xujianningkp/Wireless-Data-Traansmission/raspberry pi files/www/images/relaytower.PNG

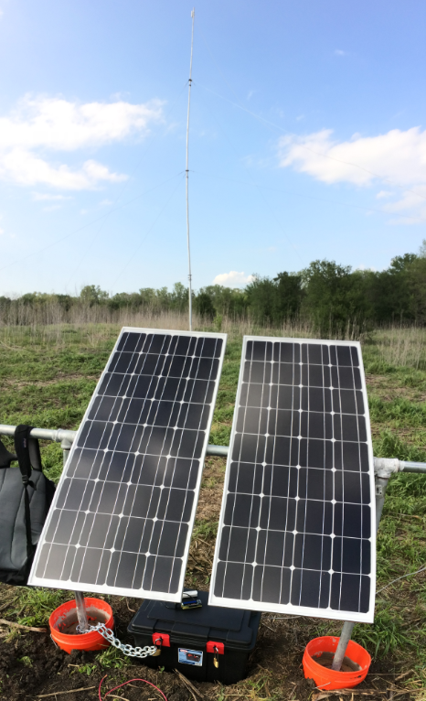
raspberry pi files/www/images/relaytower.PNG
