xujianningkp/Wireless-Data-Traansmission/raspberry pi files/www/images/nhctower.PNG

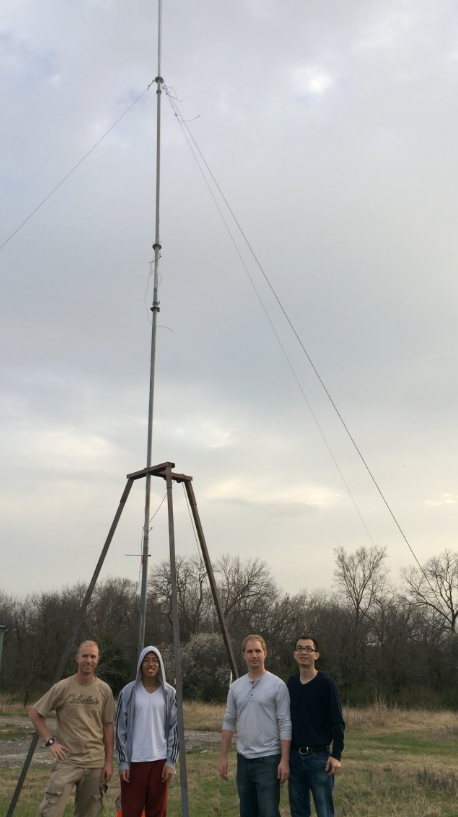
raspberry pi files/www/images/nhctower.PNG
