xujianningkp/Wireless-Data-Traansmission/moteino codes/readme.txt

libraries you will need to copy to your arduino IDE library directory.

low_Power:    power saving mode
RFM69:        RFM69W radio
RTClib:       Real time clock

Moteino order:

send -> receive -> end
