xujianningkp/Wireless-Data-Traansmission/raspberry pi files/www/images/background.png

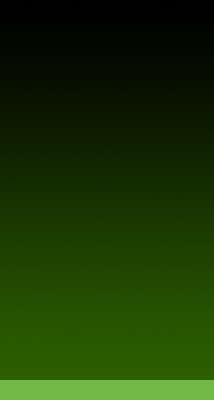
raspberry pi files/www/images/background.png
