xujianningkp/Wireless-Data-Traansmission/raspberry pi files/www/images/digram.PNG

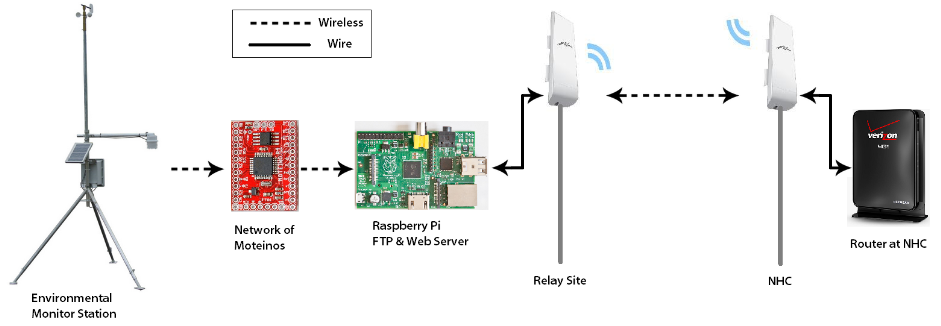
raspberry pi files/www/images/digram.PNG
