xujianningkp/Wireless-Data-Traansmission/raspberry pi files/www/images/moteino.PNG

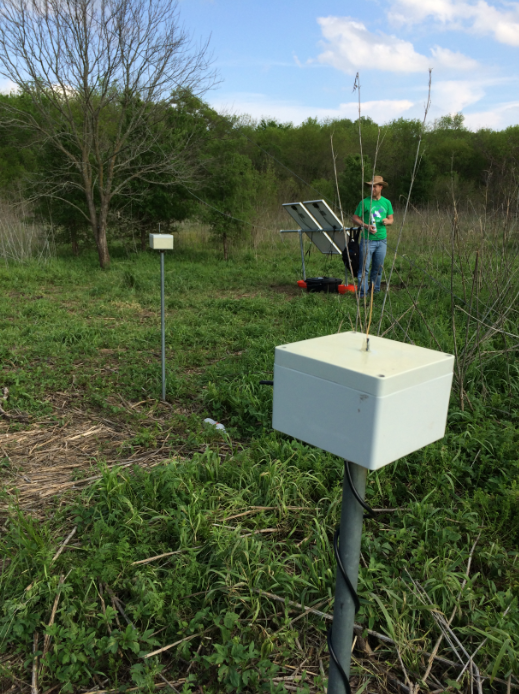
raspberry pi files/www/images/moteino.PNG
