xujianningkp/Wireless-Data-Traansmission/raspberry pi files/www/images/nhcmap.PNG

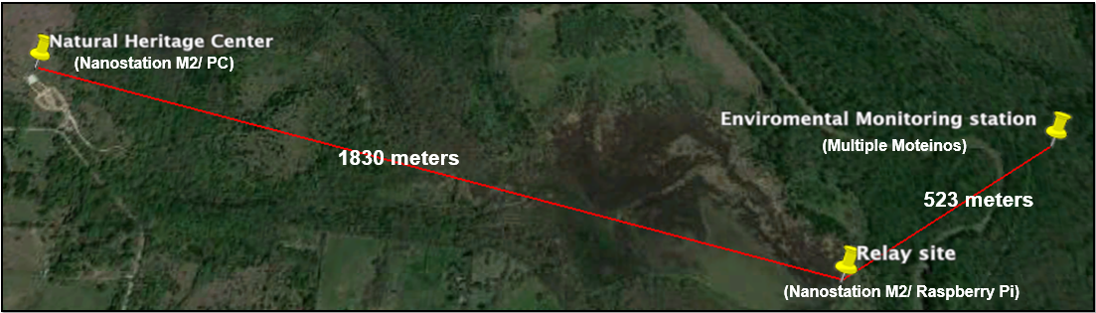
raspberry pi files/www/images/nhcmap.PNG
