xujianningkp/Wireless-Data-Traansmission/raspberry pi files/www/images/NHCproject.JPG

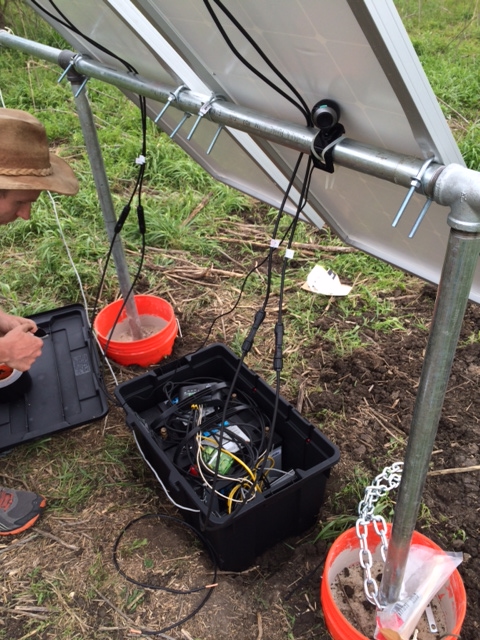
raspberry pi files/www/images/NHCproject.JPG
