xujianningkp/Wireless-Data-Traansmission/raspberry pi files/www/images/project2.JPG

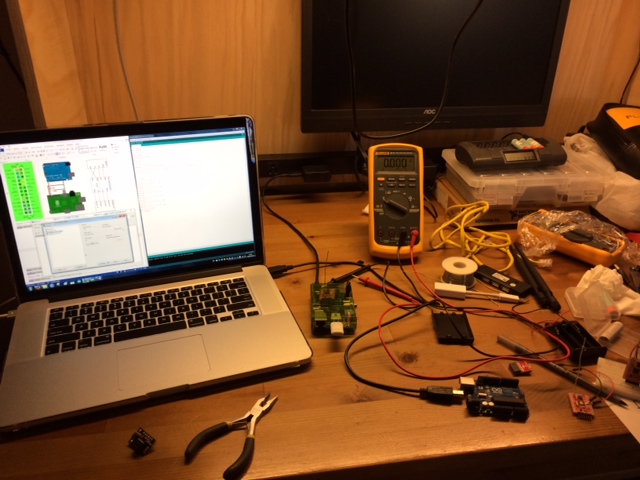
raspberry pi files/www/images/project2.JPG
