xujianningkp/Wireless-Data-Traansmission/raspberry pi files/www/images/rpidatalogger.PNG

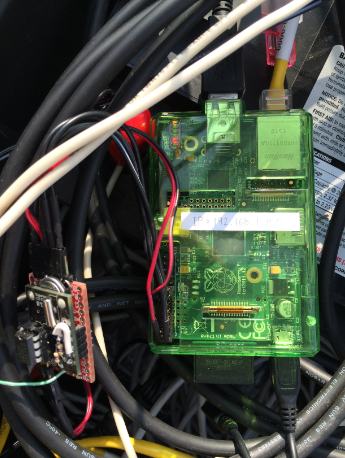
raspberry pi files/www/images/rpidatalogger.PNG
