xujianningkp/Wireless-Data-Traansmission/raspberry pi files/www/banner_edgeActions.js

/***********************
* Adobe Edge Animate Composition Actions
*
* Edit this file with caution, being careful to preserve 
* function signatures and comments starting with 'Edge' to maintain the 
* ability to interact with these actions from within Adobe Edge Animate
*
***********************/
(function($, Edge, compId){
var Composition = Edge.Composition, Symbol = Edge.Symbol; // aliases for commonly used Edge classes

   //Edge symbol: 'stage'
   (function(symbolName) {
      
      
      Symbol.bindTriggerAction(compId, symbolName, "Default Timeline", 9000, function(sym, e) {
         sym.play("loop");

      });
      //Edge binding end

   })("stage");
   //Edge symbol end:'stage'

})(jQuery, AdobeEdge, "EDGE-87532410");
